rtestardi/StickOS2/README.png

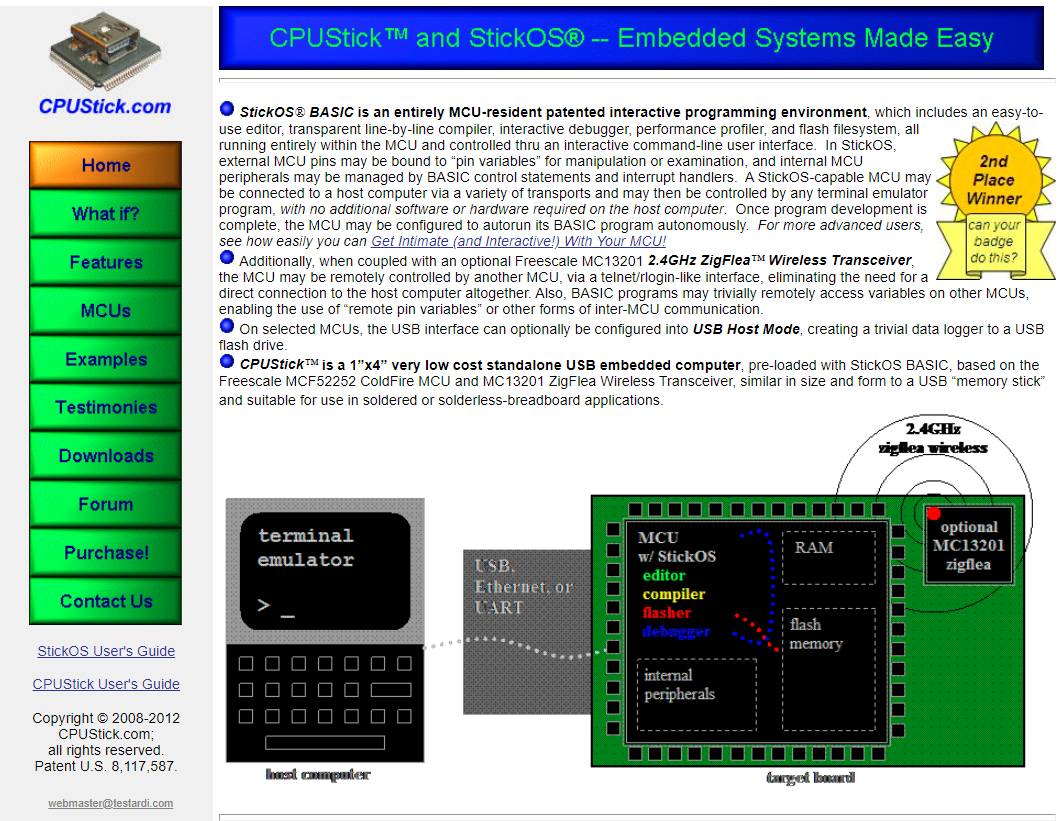
README.png
