rtestardi/StickOS2/doc/schools.docx

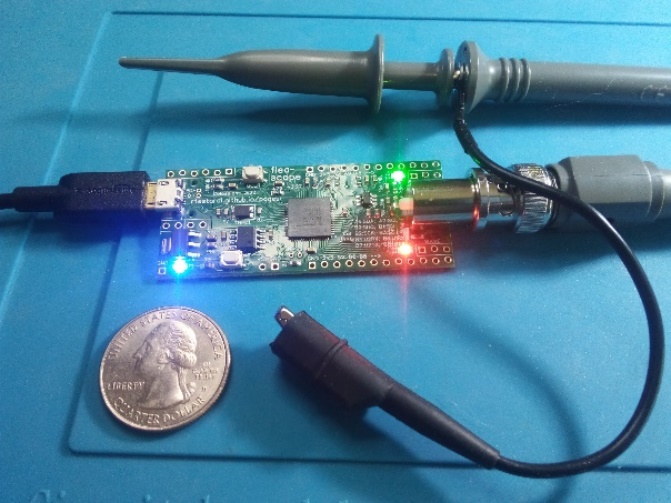
[picture p48: figure]

# Flea-Scope™ for Education (https://rtestardi.github.io/usbte/schools.pdf)

Flea-Scope™ is a very low-cost ($18 retail available here (https://www.elecrow.com/flea-scopetm-usb-o-scope.html)) and easy-to-use 18 million sample-per-second (Msps) USB oscilloscope and mixed-signal logic analyzer with a built-in waveform generator! For more advanced users, Flea-Scope is also a fully reprogrammable embedded system core! Flea-Scope can be controlled by any Chromium-based web browser that supports WebUSB API or Web Serial API running on a computer, tablet, or phone, with no need for further software install – just plug it in and open a web-page and you are up and running!

The goals of the Flea-Scope™ project are many:

1. first of all, to encourage students to become producers of technology, rather than just consumers of it!
2. then, to allow students to visualize signals changing over time as they build and debug electrical circuits,
3. to expose students to the concepts and uses of oscilloscopes, logic analyzers, and waveform generators
  - ("trigger out" pin allows multiple Flea-Scopes to work together simultaneously for more channels),
4. to excite students about the capabilities of microcontrollers (MCUs) and embedded systems, and
5. to provide students with an embedded system core which they can leverage into their own projects!

Flea-Scope™ can be used on many levels, from beginner to advanced, including:

1. (beginner, $18) as an oscilloscope, logic analyzer, and function generator, using only a web-page,
2. (intermediate, $18) as a BASIC embedded system core (https://rtestardi.github.io/StickOS/examples.htm) with debugger, using only a web-page, and
3. (advanced, $18 + $40) as a “C” embedded system core with debugger, using Snap ICE (https://www.microchip.com/en-us/development-tool/PG164100) and MPLAB X IDE.

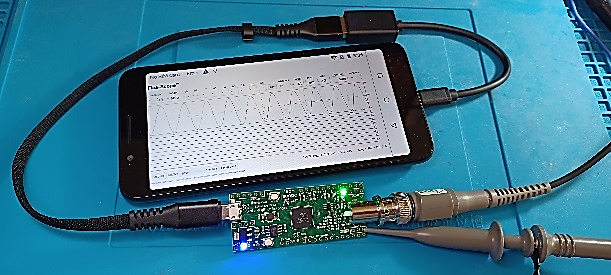
[picture p49: figure]

When used as an embedded system core, Flea-Scope™ includes 18 fully reprogrammable I/O pins, compatible with 0.1” (2.54mm) solderless breadboards!

Most of all, Flea-Scope™ is designed to be flexible and easy-to-use, with cross-platform support (Windows, macOS, Linux, ChromeOS, and Android) and a software-less install -- just open a web-page and you are up and running!

Flea-Scope™ is fully open-source, including:

- web-page GUI and deep-dive (BASIC) UI (https://github.com/rtestardi/usbte) written in JavaScript,
- MCU firmware (https://github.com/rtestardi/StickOS2) written in “C” using Microchip MPLAB X IDE (https://www.microchip.com/en-us/tools-resources/develop/mplab-x-ide),
- printed circuit board schematic and layout (https://github.com/rtestardi/StickOS2/tree/main/board) using Novarm DipTrace (https://diptrace.com/), and

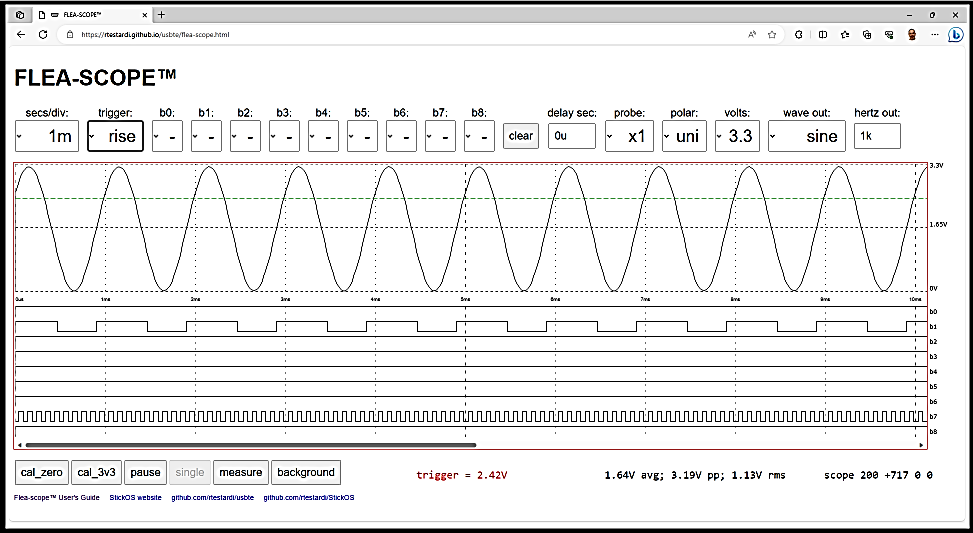
[picture p50: figure]

- extensive documentation (https://github.com/rtestardi/StickOS2/tree/main/doc).

See the Flea-Scope™ User’s Guide (https://rtestardi.github.io/usbte/flea-scope.pdf) for detailed specifications and usage.

See a list of education projects here (https://rtestardi.github.io/usbte/fun.pdf).

See a preliminary video introduction on YouTube here (https://www.youtube.com/watch?v=sbRXDkHS_V0).

For more information, contact me at: Richard Testardi <rtestardi@live.com>
