rtestardi/StickOS2/(list of files, drawings)

Other design files:
board/scope.dch
board/scope.dip
