rtestardi/StickOS2/sources/usb.c

// *** usb.c **********************************************************
// this file implements a generic usb device driver; the FTDI transport
// sits on top of this module to implement a specific usb device.

#include "main.h"

#if defined(__32MK0512GPK064__) || defined(__32MK0512MCM064__)
#define PA_TO_KVA  PA_TO_KVA0
#else
#error
#endif

#define DEVICE_DESCRIPTOR_SIZE  18
#define CONFIGURATION_DESCRIPTOR_SIZE  128

#define BULK_ATTRIBUTES  2
#define INTERRUPT_ATTRIBUTES  3

#define TOKEN_OUT  0x01
#define TOKEN_ACK  0x02
#define TOKEN_DATA0  0x03
#define TOKEN_IN  0x09
#define TOKEN_NAK  0x0a
#define TOKEN_DATA1  0x0b
#define TOKEN_SETUP  0x0d

#define BD_FLAGS_BC_ENC(x)  (((x) & 0x3ff) << 16)
#define BD_FLAGS_BC_DEC(y)  (((y) & 0x3ff0000) >> 16)
#define BD_FLAGS_OWN  0x80
#define BD_FLAGS_DATA  0x40
#define BD_FLAGS_DTS  0x08
#define BD_FLAGS_TOK_PID_DEC(y)  (((y) & 0x3c) >> 2)

#define MYBDT(endpoint, tx, odd)  (bdts+(endpoint)*4+(tx)*2+(odd))

#define BDT_RAM_SIZE  256

struct bdt {
    int flags;
    byte *buffer;
} *bdts;  // 512 byte aligned in buffer

#define ENDPOINTS  4

struct endpoint {
    byte toggle[2];  // rx [0] and tx [1] next packet data0 (0) or data1 (BD_FLAGS_DATA)
    byte bdtodd[2];  // rx [0] and tx [1] next bdt even (0) or odd (1)
    byte packetsize;
    bool inter;

    byte data_pid;  // TOKEN_IN -> data to host; TOKEN_OUT -> data from host
    int data_offset;  // current offset in data stream
    int data_length;  // max offset in data stream
    byte data_buffer[80];  // data to or from host
} endpoints[ENDPOINTS];

byte bulk_in_ep;
byte bulk_out_ep;
byte int_ep;

volatile int usb_isrs;

#if SODEBUG
volatile bool usb_in_isr;
volatile int32 usb_in_ticks;
volatile int32 usb_out_ticks;
volatile int32 usb_max_ticks;
#endif

bool cdcacm_attached;  // set when cdcacm host is attached
uint32 cdcacm_attached_count;

char usb_serial[33];

static
void
parse_configuration(const byte *configuration, int size)
{
    int i;

    // extract the bulk endpoint information
    for (i = 0; i < size; i += configuration[i]) {
        if (configuration[i+1] == ENDPOINT_DESCRIPTOR) {
            if (configuration[i+3] == BULK_ATTRIBUTES) {
                if (configuration[i+2] & 0x80) {
                    bulk_in_ep = (byte)(configuration[i+2] & 0xf);
                    assert(bulk_in_ep < LENGTHOF(endpoints));
                    assert(configuration[i+4]);
                    endpoints[bulk_in_ep].packetsize = configuration[i+4];
                } else {
                    bulk_out_ep = (byte)(configuration[i+2] & 0xf);
                    assert(bulk_out_ep < LENGTHOF(endpoints));
                    assert(configuration[i+4]);
                    endpoints[bulk_out_ep].packetsize = configuration[i+4];
                }
            } else if (configuration[i+3] == INTERRUPT_ATTRIBUTES) {
                int_ep = (byte)(configuration[i+2] & 0xf);
                assert(int_ep < LENGTHOF(endpoints));
                assert(configuration[i+4]);
                endpoints[int_ep].packetsize = configuration[i+4];
                endpoints[int_ep].inter = 1;
            }
        }
    }
    assert(i == size);
}

// *** device ***

static const byte *device_descriptor;
static int device_descriptor_length;

static const byte *configuration_descriptor;
static int configuration_descriptor_length;

static const byte *string_descriptor;
static int string_descriptor_length;

static const byte *bos_descriptor;
static int bos_descriptor_length;

static usb_reset_cbfn reset_cbfn;
static usb_control_cbfn control_transfer_cbfn;
static usb_bulk_cbfn bulk_transfer_cbfn;

// this function puts our state machine in a waiting state, waiting
// for a usb reset from the host.
static
void
usb_device_wait()
{
    // enable (only) usb reset interrupt
    U1IR = 0xff;
    U1IE = _U1IE_URSTIE_MASK;

    // enable usb device mode
    U1CON = _U1CON_USBEN_MASK;

    // enable usb pull up
    U1OTGCON = _U1OTGCON_DPPULUP_MASK|_U1OTGCON_OTGEN_MASK;
}

// this function puts our state machine into the default state,
// waiting for a "set configuration" command from the host.
static
void
usb_device_default()
{
    // default to address 0 on reset
    U1ADDR = (uint8)0;

    // enable usb device mode
    U1CON |= _U1CON_PPBRST_MASK;
    U1CON &= ~_U1CON_PPBRST_MASK;

    memset(bdts, 0, BDT_RAM_SIZE);
    memset(endpoints, 0, sizeof(endpoints));

    assert(configuration_descriptor);

    // extract the maximum packet size from the device descriptor
    endpoints[0].packetsize = device_descriptor[7];

    // parse the configuration descriptor
    parse_configuration(configuration_descriptor, configuration_descriptor_length);

    // enable (also) usb sleep and token done interrupts
    U1IR = 0xff;
    U1IE |= _U1IE_IDLEIE_MASK|_U1IE_TRNIE_MASK;

    serial_uninitialize();
}

// enqueue a packet to the usb engine for transfer to/from the host
void
usb_device_enqueue(int endpoint, bool tx, byte *buffer, int length)
{
    int ep;
    bool odd;
    int flags;
    volatile struct bdt *bdt;

    assert(endpoint < LENGTHOF(endpoints));

    if (tx != (bool)-1) {
        // transfer up to one packet at a time
        assert(endpoints[endpoint].packetsize);
        length = MIN(length, endpoints[endpoint].packetsize);

        // find the next bdt entry to use
        odd = endpoints[endpoint].bdtodd[tx];

        // initialize the bdt entry
        bdt = MYBDT(endpoint, tx, odd);
        bdt->buffer = (byte *)TF_LITTLE(KVA_TO_PA((int)buffer));
        flags = TF_LITTLE(bdt->flags);
        assert(! (flags & BD_FLAGS_OWN));
        assert(length <= endpoints[endpoint].packetsize);
        bdt->flags = TF_LITTLE(BD_FLAGS_BC_ENC(length)|BD_FLAGS_OWN|endpoints[endpoint].toggle[tx]|BD_FLAGS_DTS);
    }

    ep = _U1EP0_EPHSHK_MASK|_U1EP0_EPTXEN_MASK|_U1EP0_EPRXEN_MASK;
    ep |= endpoint?_U1EP0_EPCONDIS_MASK:0;
    // enable the packet transfer
    switch (endpoint) {
        case 0:
            U1EP0 = (uint8)(ep);
            break;
        case 1:
            U1EP1 = (uint8)(ep);
            break;
        case 2:
            U1EP2 = (uint8)(ep);
            break;
        case 3:
            U1EP3 = (uint8)(ep);
            break;
        default:
            ASSERT(0);
            break;
    }
}

static byte setup_buffer[SETUP_SIZE];  // from host
static byte next_address;  // set after successful status

// *** isr ***

static byte descriptor[DEVICE_DESCRIPTOR_SIZE];
static byte configuration[CONFIGURATION_DESCRIPTOR_SIZE];

// called by usb on device attach
void
#if ! STICK_GUEST
__ISR(_USB_1_VECTOR, PIC32IPL4)
#endif
usb_isr(void)
{
    int rv;

    usb_isrs++;
    assert(bdts);
    assert(! usb_in_isr);
    assert((usb_in_isr = true) ? true : true);
    assert((usb_in_ticks = ticks) ? true : true);

#if defined(__32MK0512GPK064__) || defined(__32MK0512MCM064__)
    IFS1CLR = _IFS1_USB1IF_MASK;
#else
#error
#endif

    // *** device ***

    // if we just transferred a token...
    if (U1IR & _U1IR_TRNIF_MASK) {
        int bc;
        int tx;
        int odd;
        int pid;
        int stat;
        int flags;
        byte *data;
        int endpoint;
        int endpoint2;
        short length;
        short value;
        volatile struct bdt *bdt;
        struct setup *setup;

        // we just completed a packet transfer
        stat = U1STAT;
        tx = !! (stat & _U1STAT_DIR_MASK);
        odd = !! (stat & _U1STAT_PPBI_MASK);
        endpoint = (stat & 0xf0) >> 4;

        // toggle the data toggle flag
        endpoints[endpoint].toggle[tx] = endpoints[endpoint].toggle[tx] ? 0 : BD_FLAGS_DATA;

        // toggle the next bdt entry to use
        ASSERT(odd == endpoints[endpoint].bdtodd[tx]);
        endpoints[endpoint].bdtodd[tx] = ! endpoints[endpoint].bdtodd[tx];

        bdt = MYBDT(endpoint, tx, odd);

        flags = TF_LITTLE(bdt->flags);
        assert(! (flags & BD_FLAGS_OWN));

        bc = BD_FLAGS_BC_DEC(flags);
        assert(bc >= 0);

        pid = BD_FLAGS_TOK_PID_DEC(flags);

        // if we're starting a new control transfer...
        if (pid == TOKEN_SETUP) {
            assert(! endpoint);
            assert(bc == 8);
            assert(! tx);

            setup = (struct setup *)TF_LITTLE((int)PA_TO_KVA((int)bdt->buffer));
            assert((void *)setup == (void *)setup_buffer);

            // unsuspend the usb packet engine
            U1CON &= ~_U1CON_TOKBUSY_MASK;

            length = TF_LITTLE(setup->length);

            endpoints[endpoint].data_pid = TOKEN_OUT;
            endpoints[endpoint].data_length = 0;
            endpoints[endpoint].data_offset = 0;

            // is this a standard command...
            if (! (setup->requesttype & 0x60)) {
                value = TF_LITTLE(setup->value);
                if (setup->request == REQUEST_GET_DESCRIPTOR) {
                    endpoints[endpoint].data_pid = TOKEN_IN;

                    if ((value >> 8) == DEVICE_DESCRIPTOR) {
                        // #1
                        assert(device_descriptor_length && device_descriptor_length <= sizeof(endpoints[endpoint].data_buffer));
                        endpoints[endpoint].data_length = MIN(device_descriptor_length, length);
                        memcpy(endpoints[endpoint].data_buffer, device_descriptor, endpoints[endpoint].data_length);
                    } else if ((value >> 8) == CONFIGURATION_DESCRIPTOR) {
                        // #2
                        assert(configuration_descriptor_length && configuration_descriptor_length <= sizeof(endpoints[endpoint].data_buffer));
                        endpoints[endpoint].data_length = MIN(configuration_descriptor_length, length);
                        memcpy(endpoints[endpoint].data_buffer, configuration_descriptor, endpoints[endpoint].data_length);
                    } else if ((value >> 8) == STRING_DESCRIPTOR) {
                        // #4
                        int i;
                        int j;
                        char *p;

                        // find the string descriptor
                        i = value & 0xff;
                        j = 0;
                        while (i-- && j < string_descriptor_length) {
                            j += string_descriptor[j];
                        }
                        if (i != -1) {
                            assert(j == string_descriptor_length);
                            endpoints[endpoint].data_length = 0;  // what to return here?
                        } else {
                            assert(string_descriptor[j]);
                            endpoints[endpoint].data_length = MIN(string_descriptor[j], length);
                            memcpy(endpoints[endpoint].data_buffer, string_descriptor+j, endpoints[endpoint].data_length);
                            if (endpoints[endpoint].data_buffer[2] == '@' || endpoints[endpoint].data_buffer[2] == '#') {
                                if (endpoints[endpoint].data_buffer[2] == '@') {
                                    // patch in the hostname
                                    p = var_get_flash_name();
                                } else {
                                    // patch in the serial number
                                    p = usb_serial;
                                }
                                endpoints[endpoint].data_buffer[0] = 2 + strlen(p)*2;
                                endpoints[endpoint].data_length = MIN(endpoints[endpoint].data_buffer[0], length);
                                for (j = 2; j < endpoints[endpoint].data_length; j += 2) {
                                    endpoints[endpoint].data_buffer[j] = *p++;
                                    endpoints[endpoint].data_buffer[j+1] = '\0';
                                }
                            }
                        }
                    } else {
                        assert(0);
                    }

                    // data phase starts with data1
                    assert(endpoints[endpoint].toggle[1] == BD_FLAGS_DATA);
                    usb_device_enqueue(0, 1, endpoints[endpoint].data_buffer, MIN(endpoints[endpoint].data_length, endpoints[endpoint].packetsize));
                } else {
                    if (setup->request == REQUEST_GET_STATUS) {
                        endpoints[endpoint].data_pid = TOKEN_IN;

                        endpoints[endpoint].data_length = 2;
                        endpoints[endpoint].data_buffer[0] = 0;
                        endpoints[endpoint].data_buffer[1] = 0;

                        // data phase starts with data1
                        assert(endpoints[endpoint].toggle[1] == BD_FLAGS_DATA);
                        usb_device_enqueue(0, 1, endpoints[endpoint].data_buffer, MIN(endpoints[endpoint].data_length, endpoints[endpoint].packetsize));
                        goto XXX_SKIP2_XXX;
                    } else if (setup->request == REQUEST_CLEAR_FEATURE) {
                        assert(! length);
                        // if we're recovering from an error...
                        if (setup->requesttype == 0x02 && ! value) {
                            endpoint2 = TF_LITTLE(setup->index) & 0x0f;
                            assert(endpoint2);
                            // clear the data toggle
                            endpoints[endpoint2].toggle[0] = 0;
                            endpoints[endpoint2].toggle[1] = 0;
                        } else {
                            assert(0);
                        }
                    } else if (setup->request == REQUEST_SET_ADDRESS) {
                        next_address = value;
                    } else if (setup->request == REQUEST_SET_CONFIGURATION) {
                        assert(value == 1);
                        cdcacm_attached_count++;
                        cdcacm_attached = 1;
                    } else if (setup->request == REQUEST_GET_CONFIGURATION) {
                        endpoints[endpoint].data_pid = TOKEN_IN;

                        endpoints[endpoint].data_length = 1;
                        endpoints[endpoint].data_buffer[0] = 1;

                        // data phase starts with data1
                        assert(endpoints[endpoint].toggle[1] == BD_FLAGS_DATA);
                        usb_device_enqueue(0, 1, endpoints[endpoint].data_buffer, MIN(endpoints[endpoint].data_length, endpoints[endpoint].packetsize));
                        goto XXX_SKIP2_XXX;
                    } else {
                        assert(0);
                    }

                    // prepare to transfer status (in the other direction)
                    usb_device_enqueue(0, 1, NULL, 0);
XXX_SKIP2_XXX:;
                }
            // otherwise, this is a class or vendor command
            } else {
                if (setup->requesttype & 0x80/*in*/) {
                    // host wants to receive data, get it from our caller!
                    assert(control_transfer_cbfn);
                    rv = control_transfer_cbfn(setup, endpoints[endpoint].data_buffer, length);
                    assert(rv >= 0);
                    assert(rv <= length);

                    // prepare to send data, TOKEN_IN(s) will follow
                    endpoints[endpoint].data_pid = TOKEN_IN;
                    assert(rv > 0);  // if you don't have a length, use out!
                    endpoints[endpoint].data_length = rv;
                    usb_device_enqueue(0, 1, endpoints[endpoint].data_buffer, endpoints[endpoint].data_length);
                } else {
                    // host is sending data
                    if (length) {
                        // we will receive data, TOKEN_OUT(s) will follow
                        endpoints[endpoint].data_length = length;
                        usb_device_enqueue(0, 0, endpoints[endpoint].data_buffer, endpoints[endpoint].packetsize);
                    } else {
                        // data transfer is done; put it to our caller!
                        assert(control_transfer_cbfn);
                        rv = control_transfer_cbfn((struct setup *)setup_buffer, NULL, 0);
                        assert(rv != -1);

                        // status uses data1
                        assert(endpoints[endpoint].toggle[1] == BD_FLAGS_DATA);

                        // prepare to transfer status (in the other direction)
                        usb_device_enqueue(0, 1, NULL, 0);
                    }
                }
            }
            assert((unsigned)endpoint < LENGTHOF(endpoints));
            assert(endpoints[endpoint].data_length <= sizeof(endpoints[endpoint].data_buffer));
        } else if (! endpoint) {
            assert(pid == TOKEN_IN || pid == TOKEN_OUT);
            data = (byte *)TF_LITTLE((int)PA_TO_KVA((int)bdt->buffer));

            // if this is part of the data transfer...
            if (pid == endpoints[endpoint].data_pid) {
                assert((char *)data >= (char *)endpoints[endpoint].data_buffer && (char *)data < (char *)endpoints[endpoint].data_buffer+sizeof(endpoints[endpoint].data_buffer));
                if (pid == TOKEN_IN) {
                    assert(tx);
                    // we just sent data to the host
                    endpoints[endpoint].data_offset += bc;
                    assert(endpoints[endpoint].data_offset <= endpoints[endpoint].data_length);

                    // if there's more data to send...
                    if (endpoints[endpoint].data_offset != endpoints[endpoint].data_length) {
                        // send it
                        usb_device_enqueue(0, 1, endpoints[endpoint].data_buffer+endpoints[endpoint].data_offset, endpoints[endpoint].data_length-endpoints[endpoint].data_offset);
                    } else {
                        // status uses data1
                        assert(endpoints[endpoint].toggle[0] == BD_FLAGS_DATA);

                        // prepare to transfer status (in the other direction)
                        usb_device_enqueue(0, 0, NULL, 0);
                    }
                } else {
                    assert(! tx);
                    // we just received data from the host
                    endpoints[endpoint].data_offset += bc;
                    assert(endpoints[endpoint].data_offset <= endpoints[endpoint].data_length);

                    // if there's more data to receive...
                    if (endpoints[endpoint].data_offset != endpoints[endpoint].data_length) {
                        // receive it
                        usb_device_enqueue(0, 0, endpoints[endpoint].data_buffer+endpoints[endpoint].data_offset, endpoints[endpoint].data_length-endpoints[endpoint].data_offset);
                    } else {
                        // put it to our caller!
                        assert(control_transfer_cbfn);
                        rv = control_transfer_cbfn((struct setup *)setup_buffer, endpoints[endpoint].data_buffer, endpoints[endpoint].data_length);
                        assert(rv != -1);

                        // status uses data1
                        assert(endpoints[endpoint].toggle[1] == BD_FLAGS_DATA);

                        // prepare to transfer status (in the other direction)
                        usb_device_enqueue(0, 1, NULL, 0);
                    }
                }
            // otherwise; we just transferred status
            } else {
                assert(data == PA_TO_KVA(0));

                // update our address after status
                if (next_address) {
                    U1ADDR |= next_address;
                    next_address = 0;
                }

                // setup always uses data0; following transactions start with data1
                endpoints[endpoint].toggle[0] = 0;
                endpoints[endpoint].toggle[1] = BD_FLAGS_DATA;

                // prepare to receive setup token
                usb_device_enqueue(0, 0, setup_buffer, sizeof(setup_buffer));
            }
        } else if (endpoint != int_ep) {
            assert(pid == TOKEN_IN || pid == TOKEN_OUT);
            data = (byte *)TF_LITTLE((int)PA_TO_KVA((int)bdt->buffer));

            // we just received or sent data from or to the host
            assert(bulk_transfer_cbfn);
            bulk_transfer_cbfn(pid == TOKEN_IN, data, bc);
        }

        U1IR = _U1IR_TRNIF_MASK;
    }

    // if we just got reset by the host...
    if (U1IR & _U1IR_URSTIF_MASK) {
        cdcacm_active = 0;
        cdcacm_attached = 0;

        usb_device_default();

        assert(reset_cbfn);
        reset_cbfn();

        // setup always uses data0; following transactions start with data1
        endpoints[0].toggle[0] = 0;
        endpoints[0].toggle[1] = BD_FLAGS_DATA;

        // prepare to receive setup token
        usb_device_enqueue(0, 0, setup_buffer, sizeof(setup_buffer));

        led_unknown_progress();

        U1IR = _U1IR_URSTIF_MASK;
    }

    // if we just went idle...
    if (U1IR & _U1IR_IDLEIF_MASK) {
        cdcacm_active = 0;
        cdcacm_attached = 0;

        // disable usb sleep interrupts
        U1IE &= ~_U1IE_IDLEIE_MASK;
        U1IR = _U1IR_IDLEIF_MASK;
    }

XXX_SKIP_XXX:
    assert(usb_in_isr);
    assert((usb_in_isr = false) ? true : true);
    assert((usb_out_ticks = ticks) ? true : true);
    assert((usb_max_ticks = MAX(usb_max_ticks, usb_out_ticks-usb_in_ticks)) ? true : true);
}

// this function is called by upper level code to register callback
// functions.
void
usb_register(usb_reset_cbfn reset, usb_control_cbfn control_transfer, usb_bulk_cbfn bulk_transfer)
{
    reset_cbfn = reset;
    control_transfer_cbfn = control_transfer;
    bulk_transfer_cbfn = bulk_transfer;
}

// called by upper level code to specify the device descriptor to
// return to the host.
void
usb_device_descriptor(const byte *descriptor, int length)
{
    device_descriptor = descriptor;
    device_descriptor_length = length;
}

// called by upper level code to specify the configuration descriptor
// to return to the host.
void
usb_configuration_descriptor(const byte *descriptor, int length)
{
    configuration_descriptor = descriptor;
    configuration_descriptor_length = length;
}

// called by upper level code to specify the string descriptors to
// return to the host.
void
usb_string_descriptor(const byte *descriptor, int length)
{
    string_descriptor = descriptor;
    string_descriptor_length = length;
}

void
usb_initialize(void)
{
    static __attribute__ ((aligned(512))) byte bdt_ram[BDT_RAM_SIZE];

    snprintf(usb_serial, sizeof(usb_serial), "%08x%08x%08x", DEVSN3^DEVSN2, DEVSN1, DEVSN0);

    bdts = (struct bdt *)bdt_ram;

    assert(BDT_RAM_SIZE >= LENGTHOF(endpoints)*4*sizeof(struct bdt));

    // power on
    U1PWRCbits.USBPWR = 1;

    // enable int
#if defined(__32MK0512GPK064__) || defined(__32MK0512MCM064__)
    IEC1bits.USB1IE = 1;
    IPC8bits.USB1IP = 4;
    IPC8bits.USB1IS = 0;
#else
#error
#endif

    // initialize usb bdt
    assert(! ((unsigned int)bdts & 0x1ff));
    U1BDTP1 = (uint8)(KVA_TO_PA((unsigned int)bdts) >> 8);
    U1BDTP2 = (uint8)(KVA_TO_PA((unsigned int)bdts) >> 16);
    U1BDTP3 = (uint8)(KVA_TO_PA((unsigned int)bdts) >> 24);

    // enable usb to interrupt on reset
    usb_device_wait();
}
