rtestardi/StickOS2/cpustick/parse2.c

// *** parse2.c *******************************************************
// this file implements private extensions to the stickos bytecode
// compiler and de-compiler.

#include "main.h"

static
const struct keyword {
    char *keyword;
    enum bytecode2 code;
} keywords[] = {
    "wave", code_wave,
    "private", code_private,
};


// this function parses (compiles) a private statement line to bytecode.
bool
parse2_line(IN char *text_in, OUT int *length_out, OUT byte *bytecode, OUT int *syntax_error_in)
{
    int i;
    int len;
    char *text;
    int length;

    text = text_in;
    parse_trim(&text);

    for (i = 0; i < LENGTHOF(keywords); i++) {
        len = strlen(keywords[i].keyword);
        if (! strncmp(text, keywords[i].keyword, len)) {
            text += len;
            break;
        }
    }
    if (i == LENGTHOF(keywords) || i == code_private) {
        goto XXX_ERROR_XXX;
    }

    parse_trim(&text);

    length = 0;
    bytecode[length++] = keywords[i].code;

    switch (keywords[i].code) {
        case code_wave:
            if (parse_word(&text, "square")) {
                bytecode[length++] = 0;
            } else if (parse_word(&text, "ekg")) {
                bytecode[length++] = 1;
            }  else if (parse_word(&text, "sine")) {
                bytecode[length++] = 2;
            }  else if (parse_word(&text, "triangle")) {
                bytecode[length++] = 3;
            } else {
                goto XXX_ERROR_XXX;
            }
            if (! parse_expression(0, &text, &length, bytecode)) {
                return false;
            }
            break;

        default:
            assert(0);
            break;
    }

    if (*text) {
        goto XXX_ERROR_XXX;
    }

    *length_out = length;
    return true;

XXX_ERROR_XXX:
    *syntax_error_in = text - text_in;
    assert(*syntax_error_in >= 0 && *syntax_error_in < BASIC_OUTPUT_LINE_SIZE);
    return false;
}

// this function unparses (de-compiles) a private statement line from bytecode.
void
unparse2_bytecode(IN byte *bytecode_in, IN int length, OUT char *text)
{
    int i;
    byte code;
    char *out;
    byte *bytecode;

    bytecode = bytecode_in;
    out = text;

    code = *bytecode++;

    // find the bytecode keyword
    for (i = 0; i < LENGTHOF(keywords); i++) {
        if (keywords[i].code == code) {
            break;
        }
    }
    assert(i != LENGTHOF(keywords));

    // decompile the bytecode keyword
    out += sprintf(out, keywords[i].keyword);
    out += sprintf(out, " ");

    switch (code) {
        case code_wave:
            code = *bytecode++;
            switch (code) {
                case 0:
                    out += sprintf(out, "square ");
                    break;
                case 1:
                    out += sprintf(out, "ekg ");
                    break;
                case 2:
                    out += sprintf(out, "sine ");
                    break;
                case 3:
                    out += sprintf(out, "triangle ");
                    break;
                default:
                    assert(0);
                    break;
            }
            bytecode += unparse_expression(0, bytecode, bytecode_in+length-bytecode, &out);
            break;

        default:
            assert(0);
            break;
    }

    assert(bytecode == bytecode_in+length);
}
