rtestardi/StickOS2/myplib.c

#include "myplib.h"

unsigned int __attribute__((nomips16))  INTEnableInterrupts(void)
{
    unsigned int status = 0;

    asm volatile("ei    %0" : "=r"(status));

    return status;
}

void __attribute__ ((nomips16)) INTEnableSystemMultiVectoredInt(void)
{
    unsigned int val;

    // set the CP0 cause IV bit high
    asm volatile("mfc0   %0,$13" : "=r"(val));
    val |= 0x00800000;
    asm volatile("mtc0   %0,$13" : "+r"(val));

    INTCONSET = _INTCON_MVEC_MASK;

    // set the CP0 status IE bit high to turn on interrupts
    INTEnableInterrupts();

}
